AranelLindi/SpaceWireRouter/(threads)

Thread 1 (2021-06-09):

Biterkennung im Taktrückgewinnungs-Front-End

AranelLindi, 2021-06-09:
Die Architektur des IPs zwingt Front-Ends bei gültigen Bits einen Signalpeak zu erzeugen, damit das markierte Bit vom Receiver als gültig anerkannt und verarbeitet wird. Verfügbare Front-Ends setzen auf Abtastung, womit die Bitübertragungsrate aber aufgrund des Abtasttheorems nach oben beschränkt ist. Das Taktrückgewinnungs-Front-End wurde entwickelt, um diese Frequenzabhängigkeit zu entkoppeln und auch höhere Übertragungsfrequenzen zuzulassen. Aufgrund der Architektur ist dies jedoch nicht möglich: Es wird eine prozessunabhängige Clock benötigt, um das Taktrückgewinnungsverfahren auf Gültigkeit abzutasten. Somit ergibt sich erneut eine Frequenzabhängigkeit. Es sollte überlegt werden, ein Validierungsschema zu entwickeln, dass gewünschte Peaks auch ohne Einbeziehung der System clock erzeugt. Rein kombinatorische Prozesse sind jedoch nicht möglich. Alternativ kann auch der Receiver dahingehend angepasst werden, was jedoch aufwendiger werden dürfte.

Thread 4 (2022-05-27):

Cmd/Non-Cmd Version

AranelLindi, 2022-05-27:
Adapter dahingehend anpassen, dass er mit Kommandos steuerbar ist aber auch eine Version erstellen, bei der er unveränderbar auf bestimmte Einstellung festgelegt ist, dafür aber alle Bits unverändert als N-Chars erkannt werden.
Dazu:
Generische Variable (true/false), welche die gewünschte Version anzeigt. Zwei Integer-Ports erstellen, welche die Ein-/Ausgangs-SpW-Ports markieren (und diesen den Standardwert 0 zuweisen).
Ebenfalls clk_cycle_per_bit als Port erstellen und gut kommentieren!

https://github.com/AranelLindi/SpaceWireRouter/blob/22bde8df7c0296785dd17a03431ddf3171c3d2f7/trunk/syn/Adapter/adapter.vhd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

Closed 2022-06-11.

Thread 5 (2022-07-03):

Resetverhalten prüfen

AranelLindi, 2022-07-03:
Prüfen wie der Router auf einen globalen Reset reagiert und wie, wenn ausschließlich ein/mehrere/alle Ports resettet werden.

Dazu (Gedanken):
- spwrouterport: Prüfen ob alle betreffenden Signale auf korrekten Wert zurückgesetzt werden. Ggf. Signal für offenes Paket einbauen und automatisiert bei Reset ein EEP erzeugen.
- Interner Bus:
Sofern der Tx-Port zurückgesetzt werden soll: Arbiter steuert Transferberechtigung. Der zurückgesetzte Port gibt aus, wann er bereit ist, ein neues N-Char vom Quellport zu akzeptieren und zu versenden. Erst dann erfolgt auch der Transfer. In diesem Szenario sollte es nach dieser oberflächlichen Prüfung zu keinen Problemen kommen. Wichtig ist hierbei nur, die Register richtig zu befüllen, damit die Software ggf. entsprechende Entscheidungen treffen kann. (Bei einem Port Reset wird ebenfalls kein EEP generiert!)

Sofern der Rx-Port zurückgesetzt wird:
In diesem Fall wird auch die Transferanfrage über den Arbiter aufgehoben, was darin resultiert, dass der Arbiter den Zugriff auf den Zielport neu vergeben könnte, welcher aber u.U noch ein offenes Paket überträgt. Eine mögliche Lösung wäre, in der Annahme, das Paket soll nach Wiederherstellung der Verbindung fortgesetzt werden, dass der Reset die Transferanfrage aufrechterhält (die betreffenden Signale also nicht zurücksetzt). Besteht der Reset jedoch gerade darin, einen Transfer eines Pakets abzubrechen, etwa um einen Konflikt aufzulösen, würde der Lösungsvorschlag zu einem Deadlock des betreffenden Zielports führen, da dieser nicht mehr vom Arbiter freigegeben wird. Eine mögliche Lösung dafür wäre der Watchdog, der einen aktiven Transfer nach einer festgelegten Anzahl Taktzyklen ohne einen Datentransfer automatisch beendet. Dieser müsste dabei auf Seiten sowohl des Quell- als auch des Zielports aktiv sein und die Anforderung an den Arbiter bzw. den internen Transferbus zurücknehmen (Quellport) als auch ein offenes Paket vorzeitig abschließen können (Zielport).

Thread 6 (2022-07-03):

Erneut auf BASYS3 Testen

AranelLindi, 2022-07-03:
routertest erneut auf BASYS3-Board laufen lassen um zu prüfen ob kürzliche Codeveränderungen auch hier die Fehler LED auslösen.

AranelLindi, 2022-07-12:
Fehler lag im Adapter, vermutlich, weil die Clocks für SpaceWire und UART aufgeteilt wurden. Diese wurden wieder zu einer einzigen Clock fusioniert, womit keine Fehler mehr auftraten.

Closed 2022-07-12.

Thread 8 (2022-12-15):

Vermutlich falscher Vergleich!

AranelLindi, 2022-12-15:
https://github.com/AranelLindi/SpaceWireRouter/blob/RegisterReDesign/trunk/rtl/vhdl/spwrouterregs_ext.vhd#L316

In Zeile 316 des extended Registers nochmal genau prüfen ob der Vergleich sinnvoll ist!

Thread 10 (2023-01-18):

Falsche Darstellung in Router-Port-Register

AranelLindi, 2023-01-18:
Darstellung in den Registern ist falsch bzw. liefert irreführende Werte. Genau prüfen ob konsequent DOWNTO oder TO verwendet wurde und ob die Zuteilung korrekt ist. Möglicher Fehler könnte auch im Code im Register selbst liegen! Prüfen ob die Aktualisierung mittels neuer Daten korrekt funktioniert.
