AranelLindi/SpaceWireRouter/trunk/syn/xc7z045-2ffg900c_ZC706/router_implementation_constr.xdc

# Clock

#set_property IOSTANDARD LVDS [get_ports clk_100MHz]
set_property DIFF_TERM TRUE [get_ports SYSCLK_P]
set_property DIFF_TERM TRUE [get_ports SYSCLK_N]
set_property PACKAGE_PIN H9 [get_ports SYSCLK_P]
set_property PACKAGE_PIN G9 [get_ports SYSCLK_N]
set_property IOSTANDARD LVDS [get_ports SYSCLK_P]
set_property IOSTANDARD LVDS [get_ports SYSCLK_N]
create_clock -name SYSCLK_P -period 5.000 -waveform {0 2.500} [get_ports SYSCLK_P]


create_generated_clock -divide_by 2 -source [get_ports SYSCLK_P] [get_pins BUFGCE_inst/O]

# SpaceWire Ports

# Port 0 (CPU-Router-Interface wird hier noch ausgelassen (wird auch nicht über FMC gelegt))

# Port 1:
# Input
set_property PACKAGE_PIN P24 [get_ports spw_di[0]]
set_property IOSTANDARD LVCMOS25 [get_ports spw_di[0]]
set_property PACKAGE_PIN P23 [get_ports spw_si[0]]
set_property IOSTANDARD LVCMOS25 [get_ports spw_si[0]]
# Output
set_property PACKAGE_PIN R21 [get_ports spw_do[0]]
set_property IOSTANDARD LVCMOS25 [get_ports spw_do[0]]
set_property PACKAGE_PIN P21 [get_ports spw_so[0]]
set_property IOSTANDARD LVCMOS25 [get_ports spw_so[0]]

# Port 2:
# Input
#set_property PACKAGE_PIN R30 [get_ports spw_di[1]]
#set_property IOSTANDARD LVCMOS25 [get_ports spw_di[1]]
#set_property PACKAGE_PIN P30 [get_ports spw_si[1]]
#set_property IOSTANDARD LVCMOS25 [get_ports spw_si[1]]
## Output
#set_property PACKAGE_PIN U29 [get_ports spw_do[1]]
#set_property IOSTANDARD LVCMOS25 [get_ports spw_do[1]]
#set_property PACKAGE_PIN T29 [get_ports spw_so[1]]
#set_property IOSTANDARD LVCMOS25 [get_ports spw_so[1]]

## Port 3:
## Input
#set_property PACKAGE_PIN T28 [get_ports spw_di[2]]
#set_property IOSTANDARD LVCMOS25 [get_ports spw_di[2]]
#set_property PACKAGE_PIN R28 [get_ports spw_si[2]]
#set_property IOSTANDARD LVCMOS25 [get_ports spw_si[2]]
## Output
#set_property PACKAGE_PIN U30 [get_ports spw_do[2]]
#set_property IOSTANDARD LVCMOS25 [get_ports spw_do[2]]
#set_property PACKAGE_PIN T30 [get_ports spw_so[2]]
#set_property IOSTANDARD LVCMOS25 [get_ports spw_so[2]]

## Port 4:
## Input
#set_property PACKAGE_PIN V26 [get_ports spw_di[3]]
#set_property IOSTANDARD LVCMOS25 [get_ports spw_di[3]]
#set_property PACKAGE_PIN V27 [get_ports spw_si[3]]
#set_property IOSTANDARD LVCMOS25 [get_ports spw_si[3]]
## Output
#set_property PACKAGE_PIN W30 [get_ports spw_do[3]]
#set_property IOSTANDARD LVCMOS25 [get_ports spw_do[3]]
#set_property PACKAGE_PIN W29 [get_ports spw_so[3]]
#set_property IOSTANDARD LVCMOS25 [get_ports spw_so[3]]


set_property PACKAGE_PIN K15 [get_ports rst]
set_property IOSTANDARD LVCMOS15 [get_ports rst]


# UART (Pmod Pins)
set_property PACKAGE_PIN AA20 [get_ports tx]
set_property IOSTANDARD LVCMOS25 [get_ports tx]
set_property PACKAGE_PIN AC18 [get_ports rx]
set_property IOSTANDARD LVCMOS25 [get_ports rx]
