AranelLindi/SpaceWireRouter/trunk/syn/xc7a35tcpg236-1_DigilentBasys3/adapter_top_constr.xdc

## Clock signal
set_property -dict { PACKAGE_PIN W5   IOSTANDARD LVCMOS33 } [get_ports clk]
create_clock -add -name sys_clk_pin -period 10.00 -waveform {0 5} [get_ports clk]


## LEDs
set_property -dict { PACKAGE_PIN U16   IOSTANDARD LVCMOS33 } [get_ports {started}]
set_property -dict { PACKAGE_PIN E19   IOSTANDARD LVCMOS33 } [get_ports {connecting}]
set_property -dict { PACKAGE_PIN U19   IOSTANDARD LVCMOS33 } [get_ports {running}]
set_property -dict { PACKAGE_PIN V19   IOSTANDARD LVCMOS33 } [get_ports {error}]
set_property -dict { PACKAGE_PIN W18   IOSTANDARD LVCMOS33 } [get_ports {txhalff}]
set_property -dict { PACKAGE_PIN U15   IOSTANDARD LVCMOS33 } [get_ports {rxhalff}]


##Buttons
# Center (Reset)
set_property -dict { PACKAGE_PIN U18   IOSTANDARD LVCMOS33 } [get_ports rst]
# Clear (Error Flags) 
set_property -dict { PACKAGE_PIN T18   IOSTANDARD LVCMOS33 } [get_ports clear]


##Pmod Header JA
set_property -dict { PACKAGE_PIN J1   IOSTANDARD LVCMOS33 } [get_ports {spw_di}];#Sch name = JA1
set_property -dict { PACKAGE_PIN H1   IOSTANDARD LVCMOS33 } [get_ports {spw_si}];#Sch name = JA7


##Pmod Header JB
set_property -dict { PACKAGE_PIN A14   IOSTANDARD LVCMOS33 } [get_ports {spw_do}];#Sch name = JB1
set_property -dict { PACKAGE_PIN A15   IOSTANDARD LVCMOS33 } [get_ports {spw_so}];#Sch name = JB7


##USB-RS232 Interface
set_property -dict { PACKAGE_PIN B18   IOSTANDARD LVCMOS33 } [get_ports rx]
set_property -dict { PACKAGE_PIN A18   IOSTANDARD LVCMOS33 } [get_ports tx]


## Configuration options, can be used for all designs
set_property CONFIG_VOLTAGE 3.3 [current_design]
set_property CFGBVS VCCO [current_design]
