AranelLindi/SpaceWireRouter/trunk/bench/vhdl/spwlink_tb_all.vhd

--
-- Run the spwlink test bench in a several configurations.
--

use work.spwpkg.all;

entity spwlink_tb_all is
end entity;

architecture tb_arch of spwlink_tb_all is

    component spwlink_tb is
        generic (
            sys_clock_freq: real        := 20.0e6 ;
            rx_clock_freq:  real        := 20.0e6 ;
            tx_clock_freq:  real        := 20.0e6 ;
            input_rate:     real        := 10.0e6 ;
            tx_clock_div:   integer     := 1 ;
            rximpl: spw_implementation_type_rec := impl_generic ;
            rxchunk:        integer     := 1 ;
            tximpl: spw_implementation_type_xmit := impl_generic ;
            startwait:      time        := 0 sec );
    end component;

begin

    -- Test 1: default configuration
    test1: spwlink_tb
        generic map (
            sys_clock_freq  => 20.0e6,
            rx_clock_freq   => 20.0e6,
            tx_clock_freq   => 20.0e6,
            input_rate      => 10.0e6,
            tx_clock_div    => 1,
            rximpl          => impl_generic,
            rxchunk         => 1,
            tximpl          => impl_generic,
            startwait       => 0 ms );

    -- Test 2: 18 Mbit input
    test2: spwlink_tb
        generic map (
            sys_clock_freq  => 20.0e6,
            rx_clock_freq   => 20.0e6,
            tx_clock_freq   => 20.0e6,
            input_rate      => 18.0e6,
            tx_clock_div    => 1,
            rximpl          => impl_generic,
            rxchunk         => 1,
            tximpl          => impl_generic,
            startwait       => 1 ms );

    -- Test 3: 2 Mbit input
    test3: spwlink_tb
        generic map (
            sys_clock_freq  => 20.0e6,
            rx_clock_freq   => 20.0e6,
            tx_clock_freq   => 20.0e6,
            input_rate      => 2.0e6,
            tx_clock_div    => 1,
            rximpl          => impl_generic,
            rxchunk         => 1,
            tximpl          => impl_generic,
            startwait       => 2 ms );

    -- Test 4: 20 Mbit output
    test4: spwlink_tb
        generic map (
            sys_clock_freq  => 20.0e6,
            rx_clock_freq   => 20.0e6,
            tx_clock_freq   => 20.0e6,
            input_rate      => 10.0e6,
            tx_clock_div    => 0,
            rximpl          => impl_generic,
            rxchunk         => 1,
            tximpl          => impl_generic,
            startwait       => 3 ms );

    -- Test 5: fast receiver, 10 Mbit in
    test5: spwlink_tb
        generic map (
            sys_clock_freq  => 20.0e6,
            rx_clock_freq   => 20.0e6,
            tx_clock_freq   => 20.0e6,
            input_rate      => 10.0e6,
            tx_clock_div    => 1,
            rximpl          => impl_fast,
            rxchunk         => 1,
            tximpl          => impl_generic,
            startwait       => 4 ms );

    -- Test 6: fast receiver, 18 Mbit in
    test6: spwlink_tb
        generic map (
            sys_clock_freq  => 20.0e6,
            rx_clock_freq   => 20.0e6,
            tx_clock_freq   => 20.0e6,
            input_rate      => 18.0e6,
            tx_clock_div    => 1,
            rximpl          => impl_fast,
            rxchunk         => 1,
            tximpl          => impl_generic,
            startwait       => 5 ms );

    -- Test 7: fast receiver, 35 Mbit in
    test7: spwlink_tb
        generic map (
            sys_clock_freq  => 20.0e6,
            rx_clock_freq   => 20.0e6,
            tx_clock_freq   => 20.0e6,
            input_rate      => 35.0e6,
            tx_clock_div    => 1,
            rximpl          => impl_fast,
            rxchunk         => 2,
            tximpl          => impl_generic,
            startwait       => 6 ms );

    -- Test 8: fast receiver, 55 Mbit in
    test8: spwlink_tb
        generic map (
            sys_clock_freq  => 20.0e6,
            rx_clock_freq   => 30.0e6,
            tx_clock_freq   => 20.0e6,
            input_rate      => 55.0e6,
            tx_clock_div    => 1,
            rximpl          => impl_fast,
            rxchunk         => 3,
            tximpl          => impl_generic,
            startwait       => 7 ms );

    -- Test 9: fast receiver, 75 Mbit in
    test9: spwlink_tb
        generic map (
            sys_clock_freq  => 20.0e6,
            rx_clock_freq   => 40.0e6,
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
            tx_clock_freq   => 77.5e6,
            input_rate      => 67.13e6,
            tx_clock_div    => 1,
            rximpl          => impl_fast,
            rxchunk         => 4,
            tximpl          => impl_fast,
            startwait       => 22 ms );

end tb_arch;
