AranelLindi/SpaceWireRouter/(commit log)

2021-05-18 Überflüssige Dateien entfernt (hauptsächlich AMBA und Leon3)
2021-05-18 Bestehende Dateien an neu konzipiertes drittes Front-End für Receiver angepasst: Taktrückgewinnung (spwrecvfront_clkrec). Design des neuen Front-ends noch nicht final, ebenfalls noch nicht auf IP mig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
2021-05-18 Fehler behoben durch den spwrecvfront_clkrec nicht included werden konnte.
    [spwrecvfront_clkrec.vhd, spwstream.vhd, streamtest.vhd, streamtest_tb.vhd]
2021-05-30 Neue Implementierung zur Taktrückgewinnung & Anpassung des IP Cores daran. Noch keine Funktionsfähigkeit im Test-Bench!
2021-06-03 Projektzustand: ClkRec funktioniert, vollständig kommentiert und eingebettet.
2021-06-06 Generische Width-Variable des Taktrückgewinnungs-Front-Ends in übergeordnete Dateien zwecks leichterer Steuerung übernommen. Default Value High von Rxen in Front-End rückgängig gemacht. Testbench für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
2021-06-28 XDC-Datei für Bitstream erstellt. Wird ohne Fehler erstellt, noch kein Live-Test auf Board! Keine Änderungen in streamtest_top. Änderung der Systemfrequenz/Dateneingangsfrequenz in spwrecvfront_clkre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
2021-07-31 Neuen Branch für Router Code Dateien erstellt. Code ohne Vivado erstellt: Keine korrekte Syntaxprüfung, Code könnte ungültig sein. Dateien so lange in diesem Branch lassen, bis Router vollständig imp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
2021-08-01 Arbiter-Code vervollständigt; noch nicht getestet; Package und Top Module für Router Table vorbereitet.
2021-08-02 RouterTable und TimeCode Control in sehr frühem Statium. Noch nicht kommentiert oder funktionstüchtig.
2021-08-03 TimeCode Control kommentiert, nachvollzogen und verbessert. Arbiter, Arbiter_round und Arbiter_Table (für Zugriff auf Register und Router Tabelle) ebenfalls weiter bearbeitet. Augenscheinlich keine F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
2021-08-05 Fehler eines doppelten Ports in TimeCodeControl und dem Top Level Package ausgebessert.
2021-08-05 Schreibfehler ausgebessert: Synchronous Reset wurde zu Asynchronous Reset
    [spwrouter.vhd, spwrouterarb.vhd, spwrouterarb_round.vhd, spwrouterarb_table.vhd, spwroutertable.vhd, spwroutertcc.vhd]
2021-08-10 Router ControlRegister Testbench begonnen (noch unfertig), Router Port als Container für spwstream begonnen (noch unfertig) und Kommentare in spwrouterregs.vhd ausgebessert.
2021-08-12 Vivado Projekt Datei angepasst und Router-zugehörige VHDL Dateien eingebunden.
2021-08-13 Projektdatei mit zusätzlicher Router-Simulation versehen. Testbench-Dateien von Syntaxfehlern befreit (Vivado) und (inkl. Taktrückgewinnungsfront-end) formatiert.
2021-08-13 Syntaxfehler ausgebessert und mit Simulation begonnen. Vorsicht: Debugport in spwrouterarb_round und spwrouterarb_round_tb eingebaut!
2021-08-14 Syntaxveränderung und vereinzelte Fehlerbehebung, die im Rahmen der Simulationstests aufgefallen sind, behoben. Zusätzlich einen Vektor in spwrouterarb_round variabel gestaltet (abhängig von Anzahl d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
    [spwrouterarb.vhd, spwrouterarb_round.vhd, spwrouterarb_round_tb.vhd, spwrouterarb_table.vhd, spwrouterarb_table_tb.vhd, spwrouterpkg.vhd]
2021-08-15 Simulationen mit allen Teilmodulen des Routers durchgeführt, die in Vivado durchgeführt werden können. In spwrouterregs häufig vorkommende Code-Teile durch Schleife ersetzt.
2021-08-16 Bei allen Code-Dateien Beschreibung aktualisiert und Fehler in BA-Titel ausgebessert. spwrouterport soweit fertig gemacht, nächster Schritt: Signale umbennen, kommentieren und in Form bringen. spwrou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
2021-08-18 Reihenfolge in Arrays geändert: Handelt es sich um eine Aufzählung (z.B. von Ports), wird TO gewählt. Im Falle von Speicheradressen oder Bits DOWNTO. spwrouter weiter vervollständigt, noch unfertig.
2021-08-22 spwrouterport vervollständigt, als nächstes: Testphase. Schreibfehler in spwrouterarb ausgebessert. Arraygrenzen in spwroutertcc angepasst (von numport-1 downto 0 auf numport downto 1 geändert), in s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
2021-08-23 Syntaxfehler in spwrouter, spwrouterarb, spwrouterfunc, spwrouterpkg, spwrouterport und spwrouterregs behoben; routertest_top erstellt, um router synthetisierbar zu machen => Synthese erfolgreich, al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
    [routertest.vhd, routertest_top.vhd, spwpkg.vhd, spwrouter.vhd, spwrouterarb.vhd, spwrouterfunc.vhd, spwrouterpkg.vhd, spwrouterport.vhd]
2021-08-24 Fehler spwrouterregs behoben (bzgl. autoTimeCodeValue), falsche Arraydimensionierung in spwroutertable behoben und dazu Testbench bzw. spwrouterpkg entsprechend angepasst. Projektdatei: Keine Ahnung 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
    [spwrouterarb_tb.vhd, spwrouterpkg.vhd, spwrouterregs.vhd, spwroutertable.vhd]
2021-08-26 Fehlerbehebung
    Fehler in spwrouterarb behoben. Testbench entsprechend angepasst. Außerdem router-Testbench weiter entwickelt (noch unfertig).
    [routertest_tb.vhd, spwrouterarb.vhd, spwrouterarb_tb.vhd, spwrouterport.vhd]
2021-08-26 Routertest und Routertest_tb weiter bearbeitet. Nächster Schritt: Simulation. spwstream dahingehend abgeändert, dass ein Default Value beim Receiver Front-End vorgegeben ist (jetzt nicht mehr, was di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
2021-08-27 Testbenchweiterentwicklung
    An Testbenches zu Router (routertest / routertest_tb) und Routerport (streamtest_spwrouterport / streamtest_spwrouterport_tb) weitergearbeitet. Dazu in spwrouterport Debugports eingebaut und Router Package entsprechend angepasst.
2021-08-29 Testbench für spwrouterport
    Linkaufbau und -haltung funktioniert. Allerdings wechselt die FSM im spwrouterport nie über S_Dest1 hinaus, weil immer nur ein single EOP/EEP erkannt wird.
2021-09-02 Routertestbench & spwstreamtest_top
    Implementierung von streamtest_top auf Basys3 gelungen, streamtest_top.vhd und Constraints (Basys3.xdc) angepasst. Weiterarbeit an Routertestbench für Simulation und Hardwareimplementierung.
2021-09-03 Routertestbench & Optimierungen
    Sämtliche Arrays in Big Endian geändert um Bugs und Missverständnisse zu vermeiden. Routertestbench weiterentwickelt. Dazu: routertest.vhd, welches das Grundgerüst darstellt: Eine Instanz des Routers und entsprechende Anzahl von außenstehenden Ports um das Senden und Empfangen von Daten zu ermöglichen. Darauf aufbauend für die Simulation ist routertest_tb. Zuletzt wird noch routertest_top entwickelt, welches eine UART-SpaceWire Schnittstelle beinhalten wird um so Daten über den Router bei einer Hardwareimplementierung schicken zu können.
    [routertest.vhd, routertest_tb.vhd, spwrouter.vhd, spwrouterarb.vhd, spwrouterfunc.vhd, spwrouterpkg.vhd, spwrouterport.vhd, spwstream.vhd]
2021-09-04 Routerfunktionsfähigkeit bewiesen!
    Ein erstes Paket wurde durch routertest_tb an den ersten Port geschickt und hat den Router korrekt durch Port 2 wieder verlassen. Davor ein Zuweisungsfehler in spwrouterarb ausgebessert, der ein falsches granted-Signal erzeugt hatte. Außerdem diverse Debugging-Ports eingefügt und durchgereicht. Diese können nach Abschluss aller Tests wieder entfernt werden.
2021-09-04 Fehlerbehebungen & Optimierungen
    Ein Funktionsfehler im Functions-Package wurde behoben. Ebenso ein Fehler in der Richtung eines Ports im Routerregister. Weiterhin wurde die logische Adressierung im Router überprüft. Nach einigen Fehlschlägen stellte sich heraus, dass der Table Arbiter seinen Dienst aufgrund des unitialisierten Zustands von Port0 verweigert (01U). Nach einer testweise Initialisierung von busMasterRequestOut := (others=>'0'); funktionierte er einwandfrei. Als letztes den Routertestbench etwas erweitert.
    [routertest_tb.vhd, spwrouter.vhd, spwrouterarb_table.vhd, spwrouterarb_table_tb.vhd, spwrouterfunc.vhd, spwrouterpkg.vhd, spwrouterregs.vhd, spwrouterregs_tb.vhd]
2021-09-05 routertest_top & uart
    Hardwareimplementierung vervollständigt. Dazu UART Reciever/Transmitter Dateien in Projekt eingefügt (noch nicht in Vivado Projektdatei!)
    Noch kein Livetest, sondern nur syntaktische Fehlerbehebung durchgeführt.
2021-09-06 Constraints
    Constraints organisiert und zusätzlich neue Datei für Hardwareimplementierung auf einzelnem Basys3 Board hinzugefügt.
2021-09-06 Hardwareimplementierung & Testbench
    UART-SpaceWire Interface ist schwieriger als erwartet. Deswegen einen Testbench für die Hardwareimplementierung erstellt. Simulation macht Fortschritte, insbesondere das Zurücksenden vom Board ist aber noch nicht fehlerfrei.
2021-09-07 Testbench zu routertest_top_single
    Simulation auf den ersten und zweiten Blick korrekt. Als nächstes: Hardwaretest. (Umbau der Versender-FSM (neue Zustände) sowie bei beiden Maschinen eine Reset-Möglichkeit eingebaut)
    [routertest_top_single.vhd, routertest_top_single_tb.vhd]
2021-09-09 Vorsicht: Falsches Simulierungsergebnis!
    Port0 wird in der Teststrecke deaktiviert und ist deswegen Unitialisiert (U), dadurch funktioniert der Routertable Arbiter (spwrouterarb_table) allerdings nicht korrekt und liefert keine Genehmigung für einen Port. In der Realität dürfte dies nicht passieren. Verhalten wurde vorsorglich in den Testbench des Routertable Arbiters eingebaut um dies zu demonstrieren.
2021-09-11 Änderungen siehe Beschreibung
    Funktionierende Simulation von routertest_top_single_tb in ModelSim. (Code noch nicht bereinigt und unaufgeräumt mit zusätzlichen Debugports). Funktion in spwrouterfunc-Package so umgeschrieben, dass immer ein Rückgabewert erfolgt (vorher uneindeutig für Synthese). Löschung von nicht benötigten Dateien des ursprünglichen Light Cores für nicht verwendete Boards (Code ist zudem teilweise veraltet). Sortierung der Dateien in Vivado Projektdatei für richtige Compilerreihenfolge. Hinzufügen einer zweiten Uart-Implementierung. Ich glaube aber inzwischen, dass auch die vorherige korrekt funktioniert hat. Es lag eher an einer irrtümlichen Zuweisung der entsp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
2021-09-12 Zwischencommit
    Erstes Paket über Uart an den Router geschickt und kam (fehlerhaft) wieder zurück. Diesen Commit als Zwischenlösung benutzen, falls im weiteren Verlauf bei der Programmierung zurückgesetzt werden muss. (Außerdem: Hinzufügen eines Clear-Buttons um Fehlerflags zu löschen)
2021-09-19 Teilerfolg Hardwareimplementierung UART/SpaceWire
    Es ist nicht möglich, Bytes von Uart zu SpaceWire zu schicken, da Uart teilweise Daten liefert, die nie vorher eingespeist wurden und damit eine falsche Portadressierung vornimmt. Aus diesem Grund wurde die folgende Vorgehensweise gewählt: Über Schalter wird der Zielport ausgewählt und stets ein Datenbyte vorausgeschickt, dass dem Zielport entspricht. Damit klappt die Zuweisung weitgehenst.
2021-09-19 Grundlage für Multi-Implementierung
    Grundlagen für Multiimplementierung gelegt (VHDL-Dateien und Constraint-Dateien) angelegt.
2021-09-20 Unstable Release State
    Kabelverbindung noch fehlerhaft, Loop Verbindung bei beiden Karten erfolgreich => Liegt vermutlich an fehlenden/falschen Constraints (ungleicher Takt beider Karten). Trotzdem alles soweit funktionstüchtig aber noch unformatiert und nicht letztendlichen Ansprüchen genügend.
    [routertest_top_multi_adapter.vhd, routertest_top_multi_adapter.xdc, routertest_top_multi_router.vhd, routertest_top_multi_router.xdc]
2021-09-22 Falsche Zuornung von TO und DOWNTO behoben
    [spwrouterarb_tb.vhd]
2021-09-29 blen Integer geändert (auf 5), damit auch maximal 32 Ports möglich werden (war vorher auf 4 und damit fehlerhaft)
2021-09-29 Erfolgreicher Test von routertest_single, vorletzter Commit vor Abgabe
    Alles funktioniert soweit bekannt (außer spwrouterport_tb, der benötigt einige Debugports um zu funktionieren), Debugports sind auskommentiert und müssen nur noch entfernt werden.
2022-05-25 Projektdatei auf Router umgestellt, im Verzeichnis etwas aufgeräumt und mit UART2SpW Adapter (verbessert) begonnen
2022-05-27 Grobe Fertigstellung des UART-SpaceWire Adapters. Kleine Änderungen im Verzeichnis (größerer Umbau bzw. Ausmisten von unnötigen Dateien folgt)
2022-05-30 Simulation des Adapters auf erstem Blick erfolgreich.
2022-06-01 Ordner umstrukturiert, nicht mehr benötigte Dateien markiert, UARTSpW Adapter funktionsfähig gemacht: Hardwaretest auf Basys3 Boards mit grundlegenden Kommandos (Pakete) funktionierten einwandfrei.
2022-06-02 Kurzanleitung für den Adapter hinzugefügt. UART Receiver dahingehend abgeändert, dass Stopbit auf korrekten Wert geprüft wird. (Simulation hat Korrektheit bestätigt) Adapter für externe Konfiguration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
2022-06-03 Adapter verfeinert, sowie eine neue Version implementiert, die nur einen SpW Port beeinhaltet und für eine direkte Kommunikation beinhaltet. UART Receiver so angepasst, dass falsche Stop Bits erkannt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
2022-06-04 Time Code Control Center verbessert und getestet
    Signale umbenannt, Kommentare hinzugefügt und verbessert. Code in geringem Umfang überarbeitet sowie Notizen (PDF) hinzugefügt. Dazu den Testbench umgestaltet und mit ModelSim getestet. Erste Ergebnisse waren zufriedenstellend. Eventuell Härtetest unterziehen. Ebenfalls Instanziierung in spwrouter abändern und Ports mit TCC verbinden.
2022-06-07 Erfolgreicher Test mit Time Codes! Sowohl manuell als auch automatisiert generiert (inkl. Kurztest der normalen Paketroutingfunktion)
2022-06-08 Code weiter strukturiert und wo es geht vereinfacht. Erste Implementierungsergebnisse waren wie gewohnt. Adapter funktioniert dahingehend noch nicht, dass Pakete vom SpaceWire Port nicht per UART aus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
2022-06-09 Restliche asynchrone Resets in synchrone Resets umgewandelt sowie Code weiter strukturiert, noch Feinarbeit nötig aber grundsätzliche Routerfunktionalität inkl. Time Codes ist gegeben.
    [spwrouter.vhd, spwrouterarb.vhd, spwrouterarb_round.vhd, spwrouterarb_table.vhd, spwrouterpkg.vhd, spwrouterport.vhd, spwrouterregs.vhd]
2022-06-10 Alte Dateien ausgemistet, einige Dateien neu formatiert, routertest_adapter_single_top auf activate_commands=false geändert, MMI und MEM Files hinzugefügt, allerdings noch nicht getestet.
2022-06-13 Ausgemistet und Dokumentation vervollständigt
2022-06-14 Weiter an MEM/MMI-Files gearbeitet (funktioniert noch nicht) sowie Adapter Testkommandos hinzugefügt
2022-06-15 Testbenches für Routertabelle und Routertabellenarbiter neu geschrieben & getestet
2022-06-27 ZYNQ7-Board hinzugefügt sowie routertest_adapter_single_top File auf Board angepasst. Kommunikation mit UART über Pmod funktioniert noch nicht. Ebenfalls: spwrouter.vhd begonnen umzugestalten, enthäl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
2022-06-29 Neues Projektfile für ZYNQ-Board hinzugefügt. routertest_adapter_single_top für ZC706 Board angepasst und über PMOD (PMOD USB-UART Adapter) lauffähig. Eventuell noch mehr testen. Adapter dahingehend 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
2022-06-30 spwrouter neu strukturiert, Signale einheitlich benannt und ggf. redundante Signale entfernt. Ebenfalls Port0 zu den anderen Ports hinzugefügt, da dieser kein Alleinstellungsmerkmal mehr hat (RMAP is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
2022-07-04 routertest wieder auf BASYS3 Board lauffähig gemacht sowie Dokumentation hinzugefügt.
2022-07-05 Testweise fertigen Router implementiert und mit den FMC Pins auf dem ZYNQ-Board (Constraints) implementiert (noch keine Messungen durchgeführt.
    [diff.txt]
2022-07-05 diff.txt gelöscht (versehentlich hinzugefügt)
    [diff.txt]
2022-07-15 Neue Implementierung für FMC-Board hinzugefügt.
2022-08-10 im Router linkstart für alle Ports auf HIGH gestellt (wieder auf LOW stellen nach Board-Debugging), SpaceWire Platinen aufbau gering modifiziert
2022-08-18 Routertestaufbau für BASYS3 Board erstellt (noch nicht getestet) um SpaceWire Platine testen zu können
2022-08-23 Äquivalentes Testdesign zur SpaceWire-Platine für das BASYS3-Board fertiggestellt und getestet. Der Aufbau erfolgte in diesem Fall so, dass eine Router-Instanz mit insgesamt 5 SpaceWire Ports erstell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
    Die Ports aufsteigend beginnend mit Port 1 wurden über die am Board befindlichen PMOD Stecker wie folgt mit Kabel verbunden:
    Port1->Port2
    Port3->Port4
    über das Paket
    00000001 00000010 00000011 00000100 00000000 00011001 11100000
    war es möglich, über den UART-SpaceWire Adapter ein Paket zu schicken, welches alle Ports des Routers einmal durchquert, um deren Funktionalität zu beweisen. Dieser Test wurde erfolgreich bewältigt.
    Es wur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
2022-08-23 Kleinere Kommentaränderungen in ReadMe und routertest_adapter_loop_top_BASYS3
2022-08-23 Fehler aus BASYS-Implementierung von routertest_adapter_loop_top in ZYNQ Implementierung korrigiert sowie kleinere syntaktische Änderungen in Constraint-File vorgenommen. Noch nicht auf Hardware gete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
    [routertest_adapter_loop_top_ZYNQ.vhd, routertest_adapter_loop_top_constr.xdc]
2022-11-29 Fixed bug in spwrouterports
    [spwrouterport.vhd, streamtest_top.vhd]
2022-11-29 Fixed bug in spwrouterports.
    [spwrouterport.vhd]
2022-12-02 First commit with new register. Syntheses complete without errors, not tested yet
    [spwrouter.vhd, spwrouterpkg.vhd, spwrouterport.vhd, spwrouterregs.vhd, spwrouterregs_ext.vhd, spwroutertable.vhd]
2022-12-05 Unsafe commit: Router works but package contains errors (problems with array_t)
    [adapter.vhd, router_implementation.vhd, router_implementation_constr.xdc, spwrouterpkg.vhd]
2022-12-05 Problems infering true dual port rams
    [adapter.vhd, router_implementation_adapter.xdc, spwrouterregs_ext.vhd]
2022-12-07 Code in erweitertem Register umgestaltet an Vorgehensweise aus AXI_SpaceWire_IP. Damit teilweise gute Resultate in Hardwaretest erzielt.
    Bekannte Fehler sind noch die folgenden:
    - Numport-Register ist leer (sollte es nicht, vermutlich irgendwo eine nicht-syntaktisch-falsche Zuweisung)
    - Running-Register enthält zwar einen Wert aber nicht den der enthalten sein sollte (3 im Test, dabei sollte es 15 oder 14 sein), nochmal prüfen wie das Signal generiert wird
    - Info-Register ist ebenfalls leer (siehe Beschreibung Numport-Register)
    Schreiben in die Routingtabelle hat funktioniert. Allerdings wurde das Paket nicht an den vorgesehenen physischen Port verschickt. Fehler könnte sowohl in der fal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
2022-12-08 Successfull Hardwaretest but still bugfixing necessary
    [spwrouter.vhd, spwrouterpkg.vhd, spwrouterport.vhd, spwrouterregs_ext.vhd]
2022-12-09 Einige Bugs im erweiterten Register beseitigt. Allerdings funktioniert logische Adressierung noch immer nicht. Testbench diesbezüglich hinzugefügt, welcher auch korrekte Ergebnisse liefert. Der Fehle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
    Des weiteren werden die Status der einzelnen Ports noch nicht korrekt auf die Speicheradressen abgebildet.
    Ebenso überlegen ob numports nicht mehr 0-basiert angezeigt wird, sondern ab 1 beginnt.
    [spwrouterregs_ext.vhd, spwrouterregs_ext_tb.vhd]
2022-12-12 Logische Adressierung funktioniert, allerdings erst nach einem initial Reset. Physische Adressierung funktioniert sofort nach dem Aufspielen. Prüfen woran dies liegt & beheben!
    Noch nicht getestet:
    Zuweisung eines Wertes über den CPU-Bus mit anschließender logischer Adressierung.
    [routertest_adapter_single_top.vhd, spwrouterport_tb_2.vhd, spwrouterregs_ext.vhd, spwrouterregs_ext_tb.vhd]
2022-12-13 Problem, dass logische Adressierung erst nach einem Reset korrekt funktioniert hatte, wurde behoben. Fehler war in diesem Fall eine nicht initialisierte Variable, die Grundlage für den Arbitrierungsm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
    Noch zu testen:
    Können alle weiteren Register korrekt abgefragt werden? (Insbesondere Router)
    Werden die Zustände aller verfügbaren Ports korrekt in das Port-Register eingetragen?
    Bekannte Probleme:
    Teilweise wird das Adressierungsfeld bei lo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
    [routertest_adapter_single_top.vhd, spwrouterarb_table.vhd, spwrouterport.vhd, spwrouterregs_ext.vhd]
2022-12-15 Extended Register etwas umgestaltet, führt allerdings dennoch zu sehr großem Ressourcenverbrauch.
    Funktionalität in kleinerem Hardwaretest gezeigt:
    - Lesender Zugriff via xsct erfolgreich (Letzter Port wird allerdings nicht angezeigt. Versucht dies mit numport+1 zu beheben, bei nächster Implementierung überprüfen!)
    - Schreibender Zugriff: Änderungen in Routing Tabelle werden korrekt berücksichtigt. Ebenfalls die Zähler für discarded Packets funktionieren und werden inkrementiert (allerdings scheinbar nur für gesamte Pakete nicht für einzelne N-Chars)
    Ebenfalls kurz getestet:
    Zugriff auf Register des CPU Interfaces. Dort funktionierte sowohl REG als auch TX und RX (Zählregister)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
2022-12-29 Standardregister dahingehend abgeändert, dass die Routingtabelle und das Intervall für automatische Time-Code Generierung mittels einer einfachen Mem-Datei initialisiert und mit Werten befüllt werden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
    Syntheseergebnis erschien richtig, als nächstes Hardwaretest durchführen!
2023-01-09 Hardware test on BASYS3 board with new (old) register was successfully! Both routing table and automatically time code generation worked as excepected. Merge into master branch.
2023-01-10 Fixed minor bugs caused by yesterday's numport change. Also bigger changes in diagram (multi channel direct memory access added; dma specific fifo added; interrupt signals changed (assignment)) Route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
    Constraint file expanded so that all ports from SpW PCB are in now.
    [adapter.vhd, router_implementation.vhd, router_implementation_adapter.xdc, spwrouter.vhd, spwrouterpkg.vhd, spwrouterregs.vhd, spwrouterregs_ext.vhd, spwroutertable.vhd]
2023-01-26 - Changed "numports-1" to "(numports-1)" - Extended register fixed: Now shows all physical ports in router registers in correct order
    [adapter.vhd, adapter_tb.vhd, router_implementation.vhd, routertest_adapter_loop_top_ZYNQ.vhd, routertest_adapter_single_top.vhd, spwrouter.vhd, spwrouterarb.vhd, spwrouterarb_round.vhd]
2023-02-01 Changelog: - Improved spwrouter for better configuration depending on externPort value - PortControl initialization added into extended register (inc. custom memory initialization file (PortControl_m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
    [adapter.vhd, router_implementation.vhd, router_implementation_adapter.xdc, routertest_adapter_single_top.vhd, spwpkg.vhd, spwrouter.vhd, spwrouterpkg.vhd, spwrouterport.vhd]
2023-04-20 again bugfixing of gitignore but works now as expected + srcs folder added with block diagram files2
    [routertest_adapter_single_top_constr.xdc]
2023-05-31 correctly working implementation (100 Mbps transfer rate)
    [main_design_wrapper.vhd]
2023-05-31 Successfully implementation of watchdog mechanism. Hardwaretests worked as expected! But deeper errors might exists and cannot be excluded
    [main_design_wrapper.vhd, spwrouter.vhd, spwrouterfunc.vhd, spwrouterpkg.vhd, spwrouterport.vhd]
2023-06-01 Broad-/Multicast functionality added and performed a hardwaretest including two Xilinx boards each consisting its own UART-SpaceWire-Adapter
2023-06-13 new constraint file für FMC-SpaceWire board rev. 0.5 added
2023-07-04 Archived transmission rate of 100 Mbps; Changed constraints for new FMC-SpaceWire board
2023-07-05 Stable version 100 Mbps; functional CPU-Interface; GPIO Ports on FMC-SpW board
2023-08-18 New version (Rev. 68 of Link-Interface) and changed interrupt signals sequence
2023-09-28 Wrong Pins for UART_0, I2C_0 and SPI_0 fixed (were first set to HPC instead of LPC!)
    [main_design_wrapper.vhd, ps7_init.h, ps7_init_gpl.h]
2023-10-12 Following changes were made to the last implementation: - Created an external port for tc_in - Created an external port for tc_out
    The two additional ports should it allow to measure both signals and to determine the time in different hardware constellations of SpaceWire Time-Codes.
    Because I wasn't sure at this moment whether the current status of the repository contained a valid implementation of the RouterPlatform, I decided to create a new branch for this purpose. As soon as the correct work of the implementation could be varified (e.g. by an hardware test) its necessary to merge this branch back into the master branch! (Because the changes were not so dramatic to justify a new branch)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
    [main_design_wrapper.vhd]
2023-10-19 Fatal error was resolved: Wrong assignment of the different clocks to rxclk resp. txclk. The valid settings are now set to: - sysfreq: 100 MHz - txclkfreq: 100 MHz - rx_impl: impl_fast - tx_impl: imp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
    Pins are connected as follows:
    - clk & txclk are connected with 100 MHz clock
    - rxclk is connected with 200 MHz clock
    Default register values for ports are changed as follows:
    - txdivcnt from 0x01 to 0x00 to allow a transfer rate of 100 Mbps (txclk is then divided by one)
    Additional changes that were made:
    - Input values to spwstream like 'Autostart' or 'Linkstart' are now taken from registers (same as txdivcnt)
    This leads to the fact that ports of the router now do not try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
    [main_design_wrapper.vhd, router_implementation.vhd, spwrouter.vhd]
2023-10-19 Hardware tests including CPU-Interface and UART-SpaceWire-Adapter were sucessful. Ready for Time-Code Measurements!
2024-04-17 Gefixtes Link-Interface (bzw. CPU-Interface) eingebunden. AXI SmartConnect durch AXI Interconnect ersetzt. Bug in Speichertabelle behoben durch den DMA Controller keinen Zugriff auf Hardwarekomponent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
    [main_design_wrapper.vhd]
2024-04-22 Bug behoben, dass DMA Controller stets ein Datenfeld übersprungen hatten: Wordbreite der beiden HP Ports war auf 64 Bit eingestellt -> Abgeändert auf 32 Bits, DMA Controller funktionieren jetzt wie v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
    [main_design_wrapper.vhd]
2024-04-30 Prinzipiell voll funktionsfähiges Design. ABER:
    - Beide DMA Controller überspringen jedes zweite Feld (mit System ILA überprüft) als wäre die Wortbreite 64 Bit - finde aber nirgends eine Einstellung die nicht 32 Bit ist.
    Dies lässt sich Workarounden, benötigt dann aber doppelt so viel Speicherplatz (sollte dennoch kein Problem sein)
    - Sowohl PS wie auch DMA Controller können beide auf SpW-CPU-Interface zugreifen
    [main_design_wrapper.vhd]
2024-05-03 Problem mit DMA Transfers behoben!
    - HP0 Port Datenbreite: 32 Bits
    - HP1 Port Datenbreite: 64 Bits
    Erklärung: Lesen des DMA Controllers funktioniert mit 32 Bit, Daten werden - mit System ILA nachvollzogen - korrekt gelesen und an CPU-Interface weitergegeben
    Wäre HP1 Port Datenbreite ebenfalls 32 Bits (da existiert wohl ein Bug seitens Vivado, der die internen Settings trotzdem auf 64 Bit lässt) würde dazu führen, dass jedes zweite Datenwort nicht transferiert würde - ebenfalls mit System ILA nachvollzogen. Die Änderung der Datenbreite auf 64 Bit führt dazu, dass die übrigen 64 - 32 Bits abgeschnitten werden (oder so ähnlich). Jedenfalls funktioniert damit der RX Transfer.
    ABER:
    D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
    [main_design_wrapper.vhd]
2024-07-10 Status interrupts for every port added.
2024-07-10 Fixed a little bug: interrupt signals were not connected in the main level file.
    [main_design_wrapper.vhd, router_implementation.vhd]
2025-03-14 Letzte Änderunen am Router. Finaler Status des SoC
